ElectronicCats/RAMN/hardware/V1_revB/Global_Library/3D/5002.step

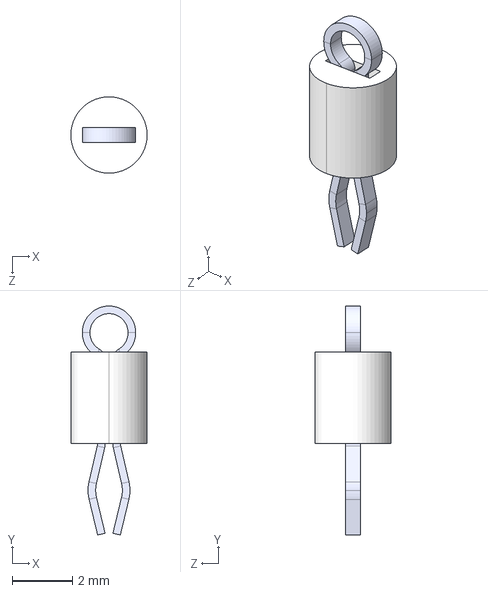
[picture p1: CAD file, 2024-08-29]
hardware/V1_revB/Global_Library/3D/5002.step
2.54 x 7.62 x 2.54 mm
