ElectronicCats/RAMN/hardware/V1_revB/3_powertrain/powertrain.kicad_pcb

## KiCad design hardware/V1_revB/3_powertrain/powertrain.kicad_pcb (2026-10-14)

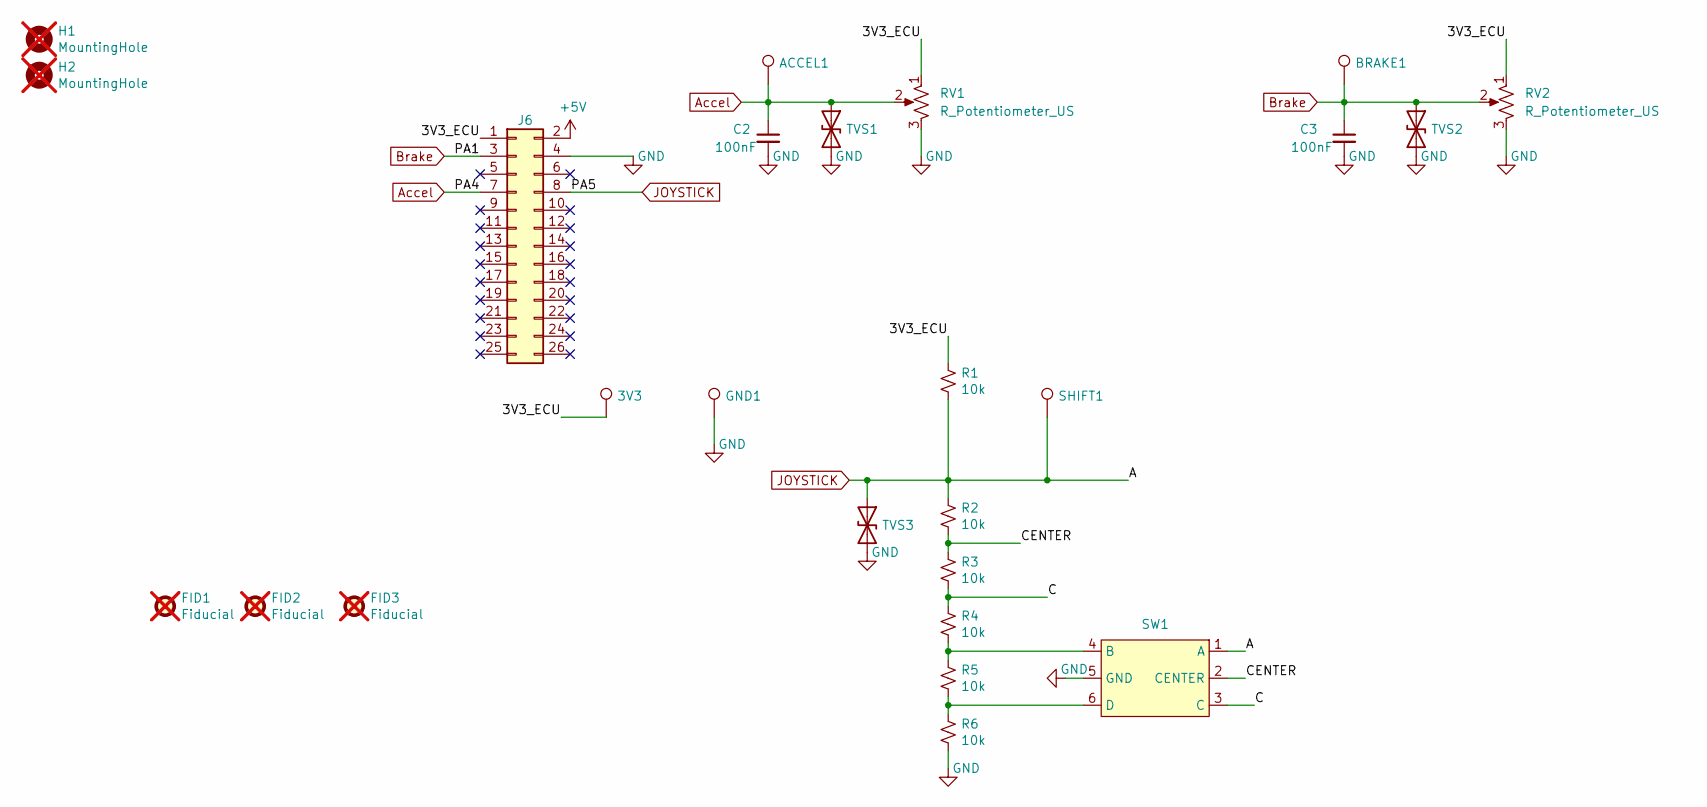
[picture p2: schematic powertrain.kicad_sch, Powertrain - RAMN: Resistant Automotive Miniature Network V1]

Parts:
3V3: TestPoint; KEYSTONE_5002; lcsc# C5277086
ACCEL1: TestPoint; KEYSTONE_5002; lcsc# C5277086
BRAKE1: TestPoint; KEYSTONE_5002; lcsc# C5277086
C2, C3: 100nF; C_0603_1608Metric; lcsc# C282519
FID1, FID2, FID3: Fiducial; Fiducial_1mm_Mask2mm; not fitted
GND1: TestPoint; KEYSTONE_5002; lcsc# C5277086
H1, H2: MountingHole; MountingHole_3.2mm_M3_ISO7380; not fitted
J6: PinSocket_2x13_P2.54mm_Vertical; lcsc# C2897414
R1, R2, R3, R4, R5, R6: 10k; R_0603_1608Metric; lcsc# C209220
RV1, RV2: R_Potentiometer_US; RS15111A900B; lcsc# C470417
SHIFT1: TestPoint; KEYSTONE_5002; lcsc# C5277086
SW1: SKRHADE010; lcsc# C202415
TVS1, TVS2, TVS3: D_TVS; D_SOD-123F; lcsc# C1849694

Connections:
+5V: J6.2
/3V3_ECU: 3V3.1 (1_1), J6.1, R1.1, RV1.1, RV2.1
/C: R3.2, R4.1, SW1.3 (C)
/CENTER: R2.2, R3.1, SW1.2 (CENTER)
Accel: ACCEL1.1 (1_1), C2.1, J6.7, RV1.2, TVS1.1 (A1)
Brake: BRAKE1.1 (1_1), C3.1, J6.3, RV2.2, TVS2.1 (A1)
GND: C2.2, C3.2, GND1.1 (1_1), J6.4, R6.2, RV1.3, RV2.3, SW1.5 (GND), TVS1.2 (A2), TVS2.2 (A2), TVS3.2 (A2)
JOYSTICK: J6.8, R1.2, R2.1, SHIFT1.1 (1_1), SW1.1 (A), TVS3.1 (A1)
unnamed: R4.2, R5.1, SW1.4 (B)
unnamed: R5.2, R6.1, SW1.6 (D)

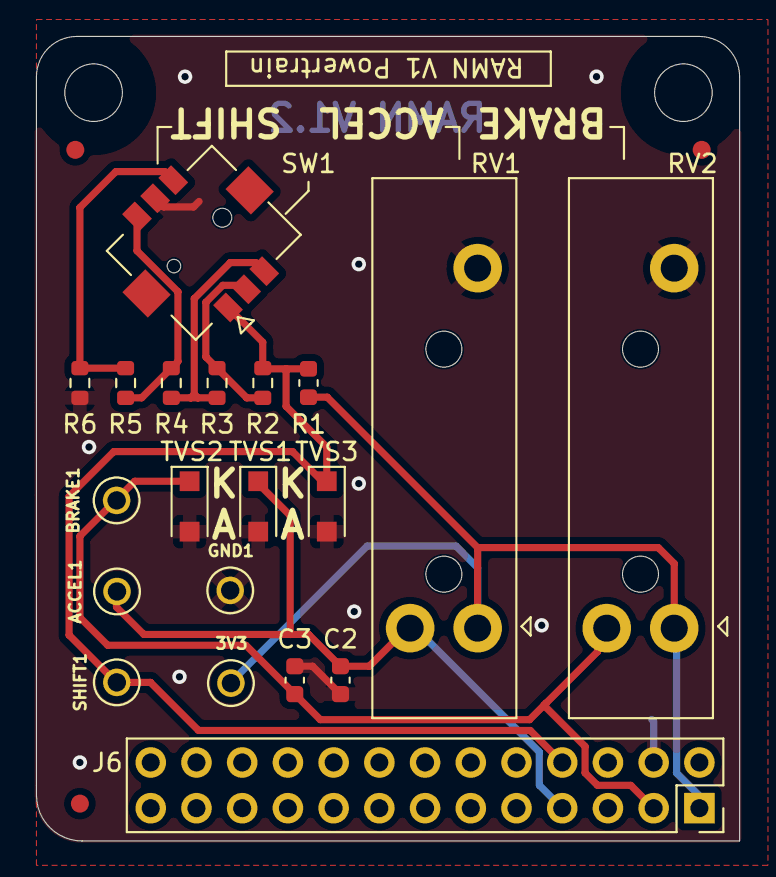
[picture p3: board powertrain.kicad_pcb from above]

Board: 2 copper layers, 39.1 x 44.7 mm, 25 parts (0 on the bottom side), 9 nets.
