ElectronicCats/RAMN/hardware/V1_revB/2_chassis/chassis.kicad_pcb

## KiCad design hardware/V1_revB/2_chassis/chassis.kicad_pcb (2026-10-14)

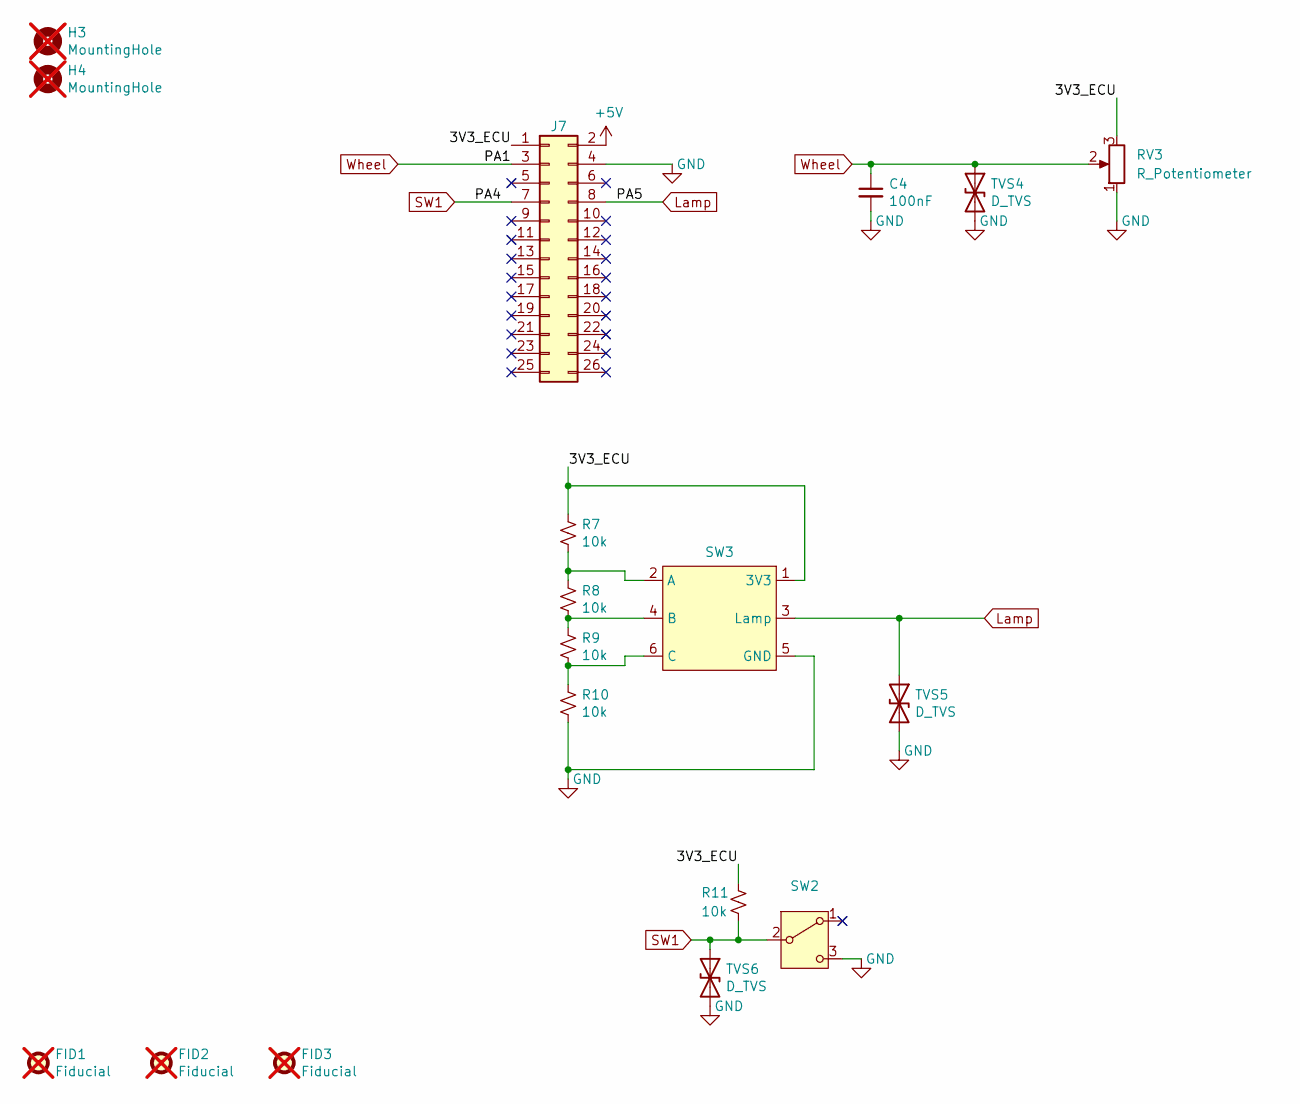
[picture p4: schematic chassis.kicad_sch, Chassis - RAMN: Resistant Automotive Miniature Network V1]

Parts:
C4: 100nF; C_0603_1608Metric; lcsc# C282519
FID1, FID2, FID3: Fiducial; Fiducial_1mm_Mask2mm; not fitted
H3, H4: MountingHole; MountingHole_3.2mm_M3_ISO7380; not fitted
J7: PinSocket_2x13_P2.54mm_Vertical; lcsc# C2897414
R7, R8, R9, R10, R11: 10k; R_0603_1608Metric; lcsc# C73809
RV3: R_Potentiometer; New_Pot; lcsc# C6139964
SW2: SW_CuK_OS102011MA1QN1_SPDT_Angled; lcsc# C226259
SW3: NR01; lcsc# C7250022
TVS4, TVS5, TVS6: D_TVS; D_SOD-123F; lcsc# C1849694

Connections:
+5V: J7.2
/3V3_ECU: J7.1, R7.1, R11.2, RV3.3, SW3.1 (3V3)
GND: C4.2, J7.4, R10.2, RV3.1, SW2.3 (C), SW3.5 (GND), TVS4.2 (A2), TVS5.2 (A2), TVS6.2 (A2)
Lamp: J7.8, SW3.3 (Lamp), TVS5.1 (A1)
unnamed: R7.2, R8.1, SW3.2 (A)
unnamed: R8.2, R9.1, SW3.4 (B)
unnamed: R9.2, R10.1, SW3.6 (C)
SW1: J7.7, R11.1, SW2.2 (B), TVS6.1 (A1)
Wheel: C4.1, J7.3, RV3.2, TVS4.1 (A1)

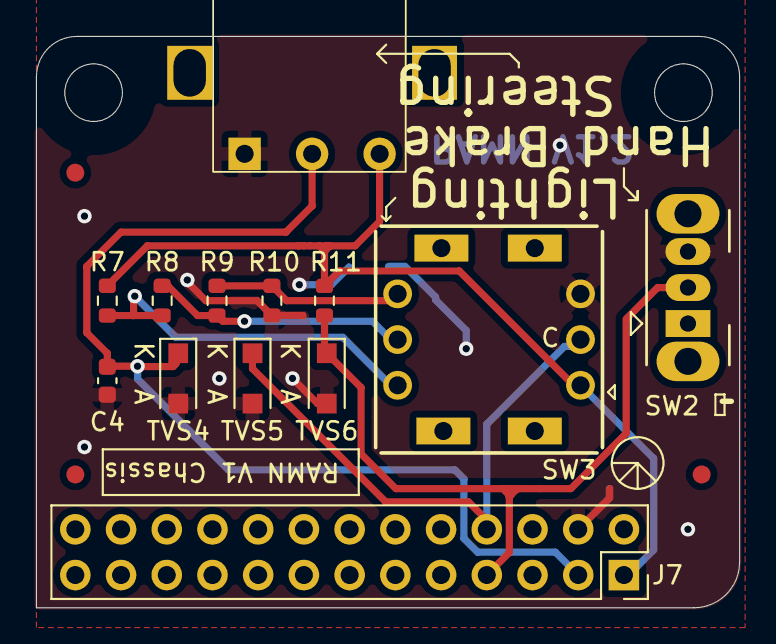
[picture p5: board chassis.kicad_pcb from above]

Board: 2 copper layers, 39.1 x 31.7 mm, 18 parts (0 on the bottom side), 8 nets.
