ElectronicCats/RAMN/hardware/V1_revB/4_body/body.kicad_pcb

## KiCad design hardware/V1_revB/4_body/body.kicad_pcb (2026-09-14)

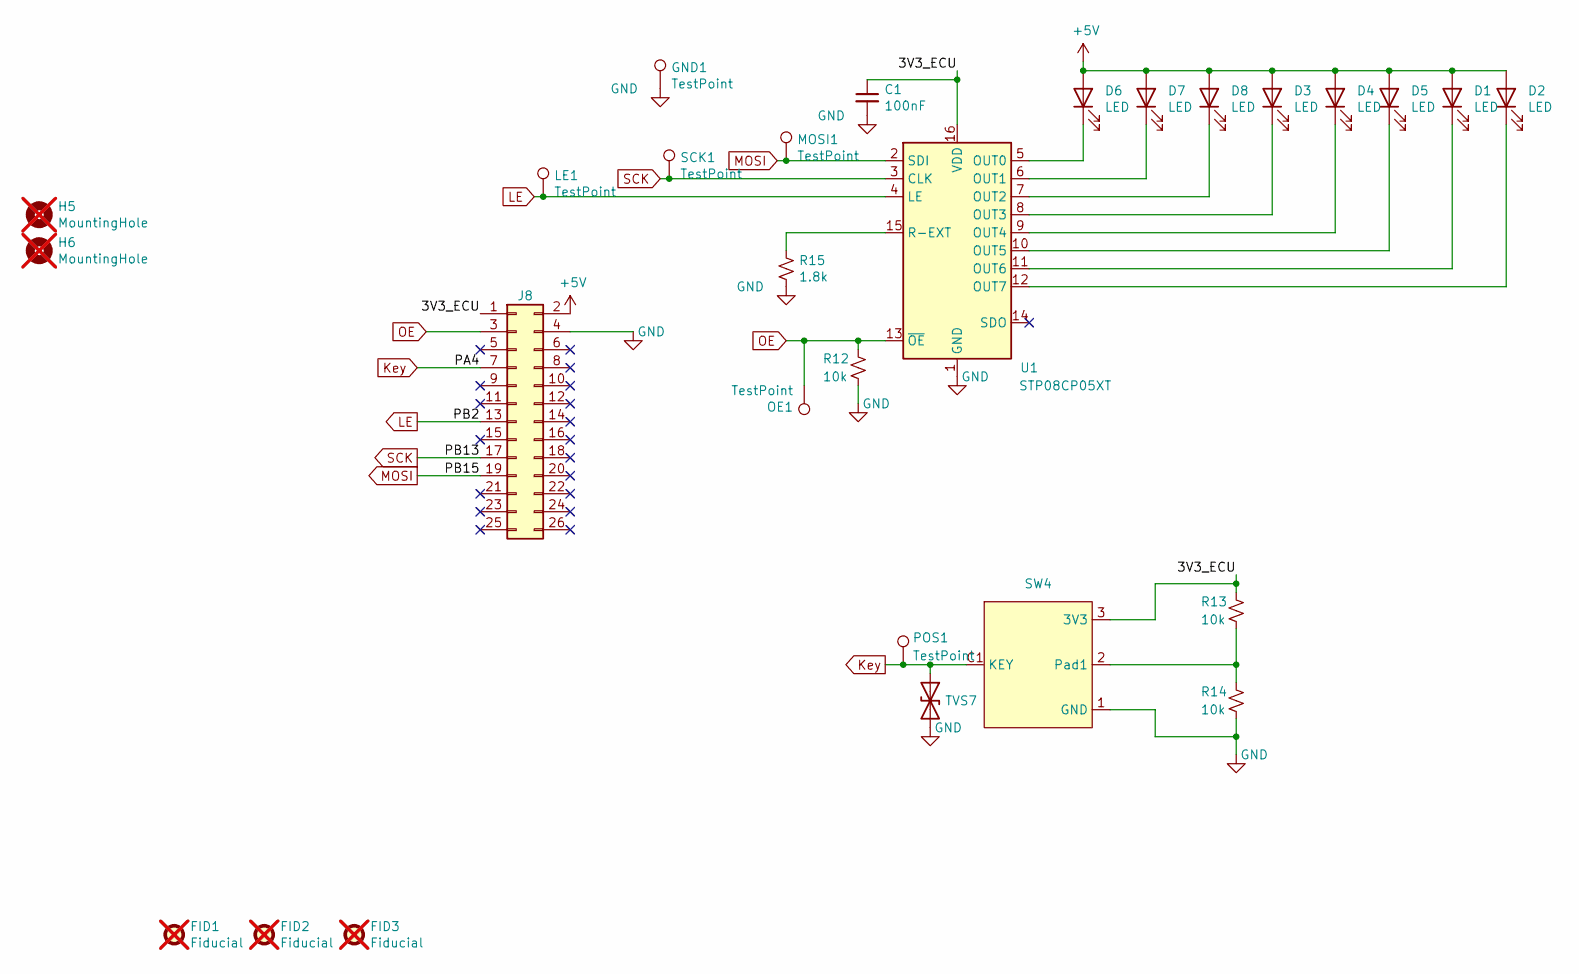
[picture p6: schematic body.kicad_sch, Body - RAMN: Resistant Automotive Miniature Network V1]

Parts:
C1: 100nF; C_0603_1608Metric; lcsc# C282519
D1, D2, D6: LED; LED_0603_1608Metric; lcsc# C51933295
D3, D4, D5: LED; LED_0603_1608Metric; lcsc# C510294
D7: LED; LED_0603_1608Metric; lcsc# C19273153
D8: LED; LED_0603_1608Metric; lcsc# C51933292
FID1, FID2, FID3: Fiducial; Fiducial_1mm_Mask2mm; not fitted
GND1: TestPoint; KEYSTONE_5002; lcsc# C5277086
H5, H6: MountingHole; MountingHole_3.2mm_M3_ISO7380; not fitted
J8: PinSocket_2x13_P2.54mm_Vertical; lcsc# C2897414
LE1: TestPoint; KEYSTONE_5002; lcsc# C5277086
MOSI1: TestPoint; KEYSTONE_5002; lcsc# C5277086
OE1: TestPoint; KEYSTONE_5002; lcsc# C5277086
POS1: TestPoint; KEYSTONE_5002; lcsc# C5277086
R12, R13, R14: 10k; R_0603_1608Metric; lcsc# C209220
R15: 1.8k; R_0603_1608Metric; lcsc# C171725
SCK1: TestPoint; KEYSTONE_5002; lcsc# C5277086
SW4: SK14dG13; lcsc# C34362858
TVS7: D_TVS; D_SOD-123F; lcsc# C1849694
U1: STP08CP05XT; HTSSOP-16-1EP_4.4x5mm_P0.65mm_EP3x3mm; lcsc# C2678539

Connections:
+5V: D1.2 (A), D2.2 (A), D3.2 (A), D4.2 (A), D5.2 (A), D6.2 (A), D7.2 (A), D8.2 (A), J8.2
/3V3_ECU: C1.1, J8.1, R13.2, SW4.3 (3V3), U1.16 (VDD)
GND: C1.2, GND1.1 (1_1), J8.4, R12.1, R14.1, R15.1, SW4.1 (GND), TVS7.2 (A2), U1.1 (GND), U1.17 (GND)
Key: J8.7, POS1.1 (1_1), SW4.C1 (KEY), TVS7.1 (A1)
LE: J8.13, LE1.1 (1_1), U1.4 (LE)
MOSI: J8.19, MOSI1.1 (1_1), U1.2 (SDI)
unnamed: D1.1 (K), U1.11 (OUT6)
unnamed: D2.1 (K), U1.12 (OUT7)
unnamed: D3.1 (K), U1.8 (OUT3)
unnamed: D4.1 (K), U1.9 (OUT4)
unnamed: D5.1 (K), U1.10 (OUT5)
unnamed: D6.1 (K), U1.5 (OUT0)
unnamed: D7.1 (K), U1.6 (OUT1)
unnamed: D8.1 (K), U1.7 (OUT2)
unnamed: R13.1, R14.2, SW4.2 (Pad1)
unnamed: R15.2, U1.15 (R-EXT)
OE: J8.3, OE1.1 (1_1), R12.2, U1.13 (~OE)
SCK: J8.17, SCK1.1 (1_1), U1.3 (CLK)

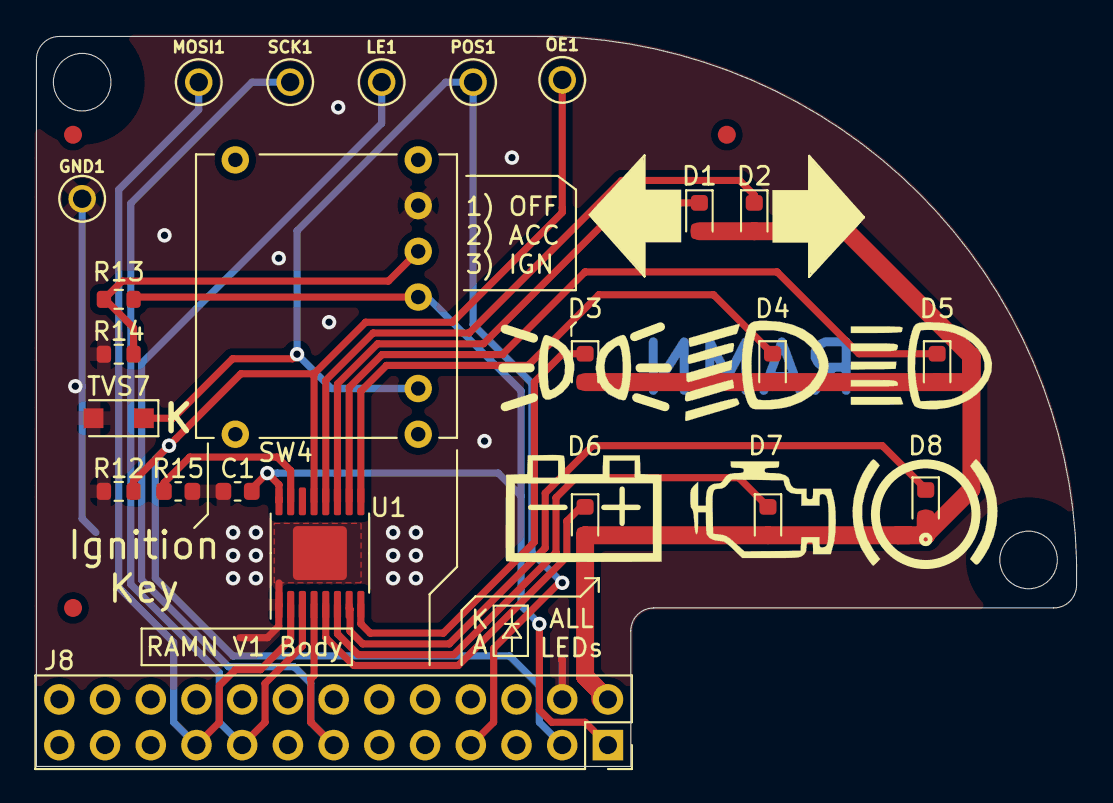
[picture p7: board body.kicad_pcb from above]

Board: 2 copper layers, 57.8 x 40.6 mm, 28 parts (0 on the bottom side), 18 nets.
