ElectronicCats/RAMN/hardware/V1_revB/1_screens/screens.kicad_pcb

## KiCad design hardware/V1_revB/1_screens/screens.kicad_pcb (2026-09-14)

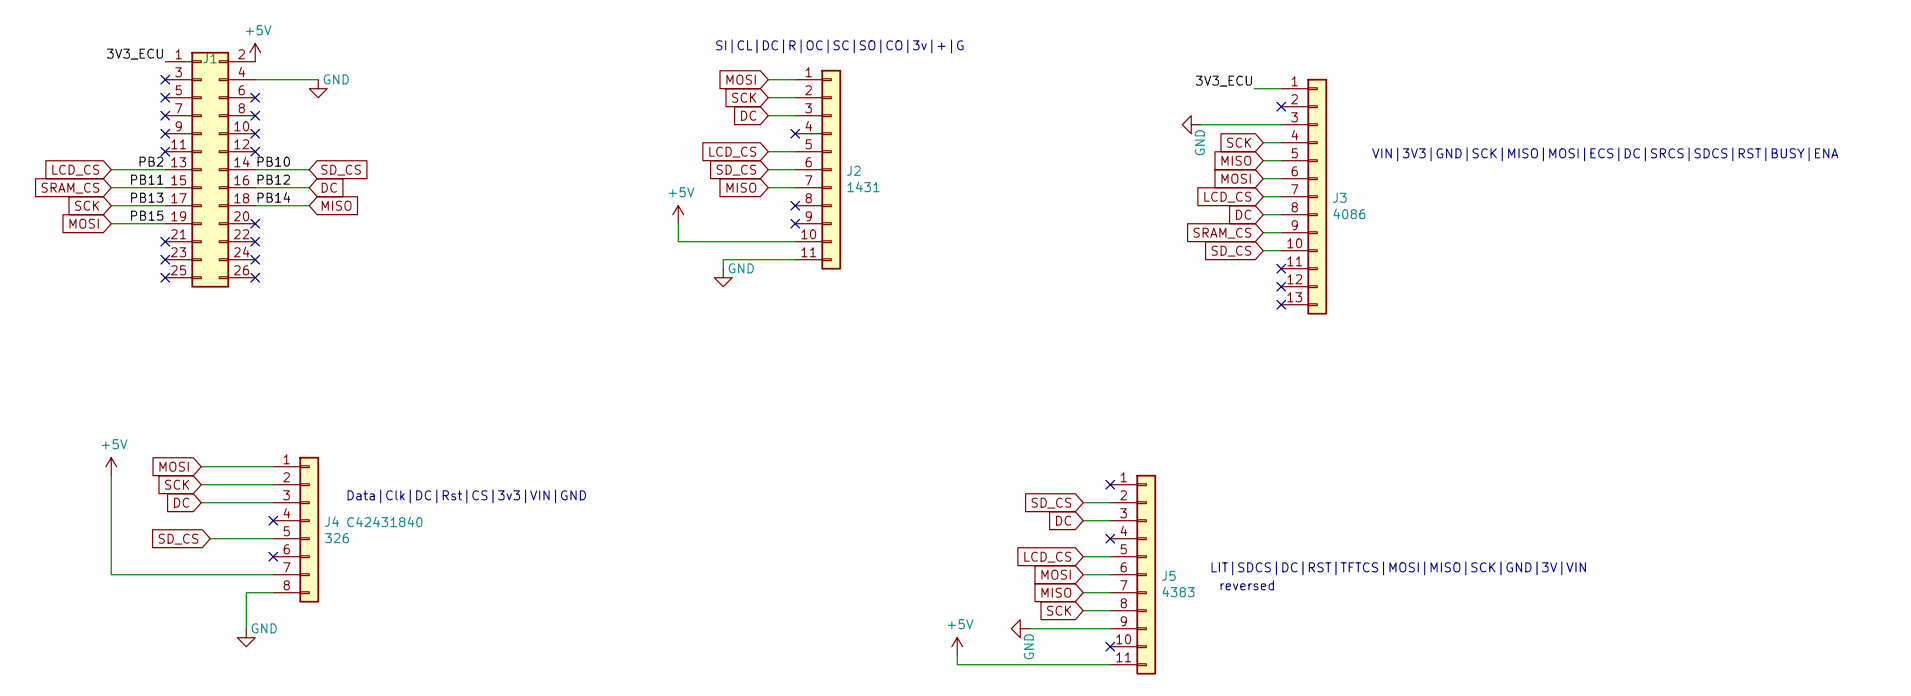
[picture p8: schematic screens.kicad_sch, Screens - RAMN: Resistant Automotive Miniature Network V1]

Parts:
J1: PinHeader_2x13_P2.54mm_Horizontal; LCSC C5412932
J2: 1431; PinSocket_1x11_P2.54mm_Vertical; LCSC C41417323
J3: 4086; PinSocket_1x13_P2.54mm_Vertical; LCSC C2905420
J4: 326; PinSocket_1x08_P2.54mm_Vertical; LCSC C42431840
J5: 4383; PinSocket_1x11_P2.54mm_Vertical; LCSC C41417323

Connections:
+5V: J1.2, J2.10, J4.7, J5.11
/3V3_ECU: J1.1, J3.1
DC: J1.16, J2.3, J3.8, J4.3, J5.3
GND: J1.4, J2.11, J3.3, J4.8, J5.9
LCD_CS: J1.13, J2.5, J3.7, J5.5
MISO: J1.18, J2.7, J3.5, J5.7
MOSI: J1.19, J2.1, J3.6, J4.1, J5.6
SCK: J1.17, J2.2, J3.4, J4.2, J5.8
SD_CS: J1.14, J2.6, J3.10, J4.5, J5.2
SRAM_CS: J1.15, J3.9

Notes on the sheet:
reversed
Data|Clk|DC|Rst|CS|3v3|VIN|GND
LIT|SDCS|DC|RST|TFTCS|MOSI|MISO|SCK|GND|3V|VIN
VIN|3V3|GND|SCK|MISO|MOSI|ECS|DC|SRCS|SDCS|RST|BUSY|ENA
SI|CL|DC|R|OC|SC|SO|CO|3v|+|G

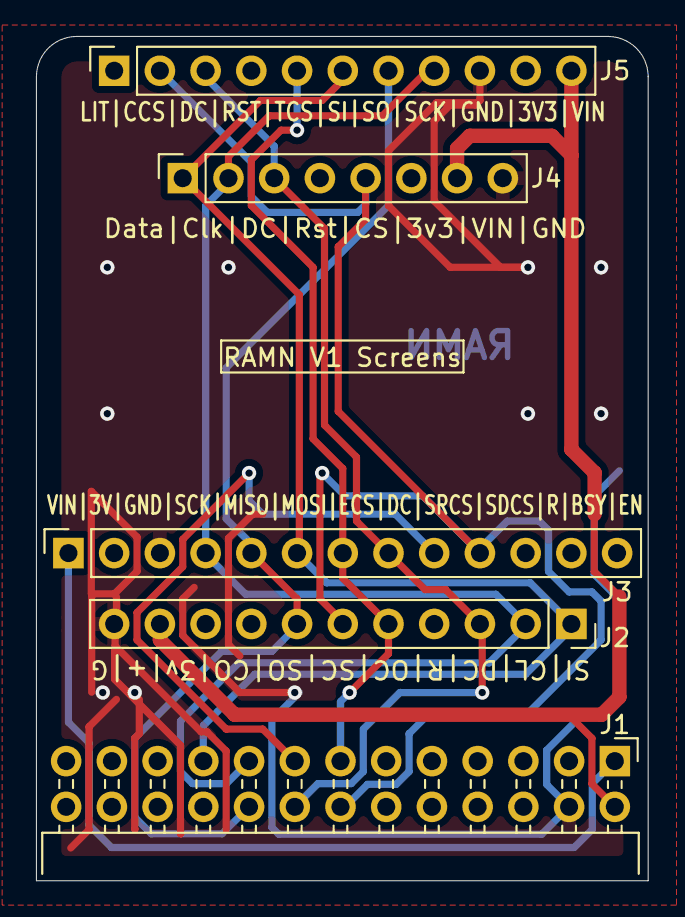
[picture p9: board screens.kicad_pcb from above]

Board: 2 copper layers, 34.0 x 46.9 mm, 5 parts (0 on the bottom side), 10 nets.
