ElectronicCats/RAMN/hardware/V1_revB/5_debugger/debugger.kicad_pcb

## KiCad design hardware/V1_revB/5_debugger/debugger.kicad_pcb (2026-09-14)

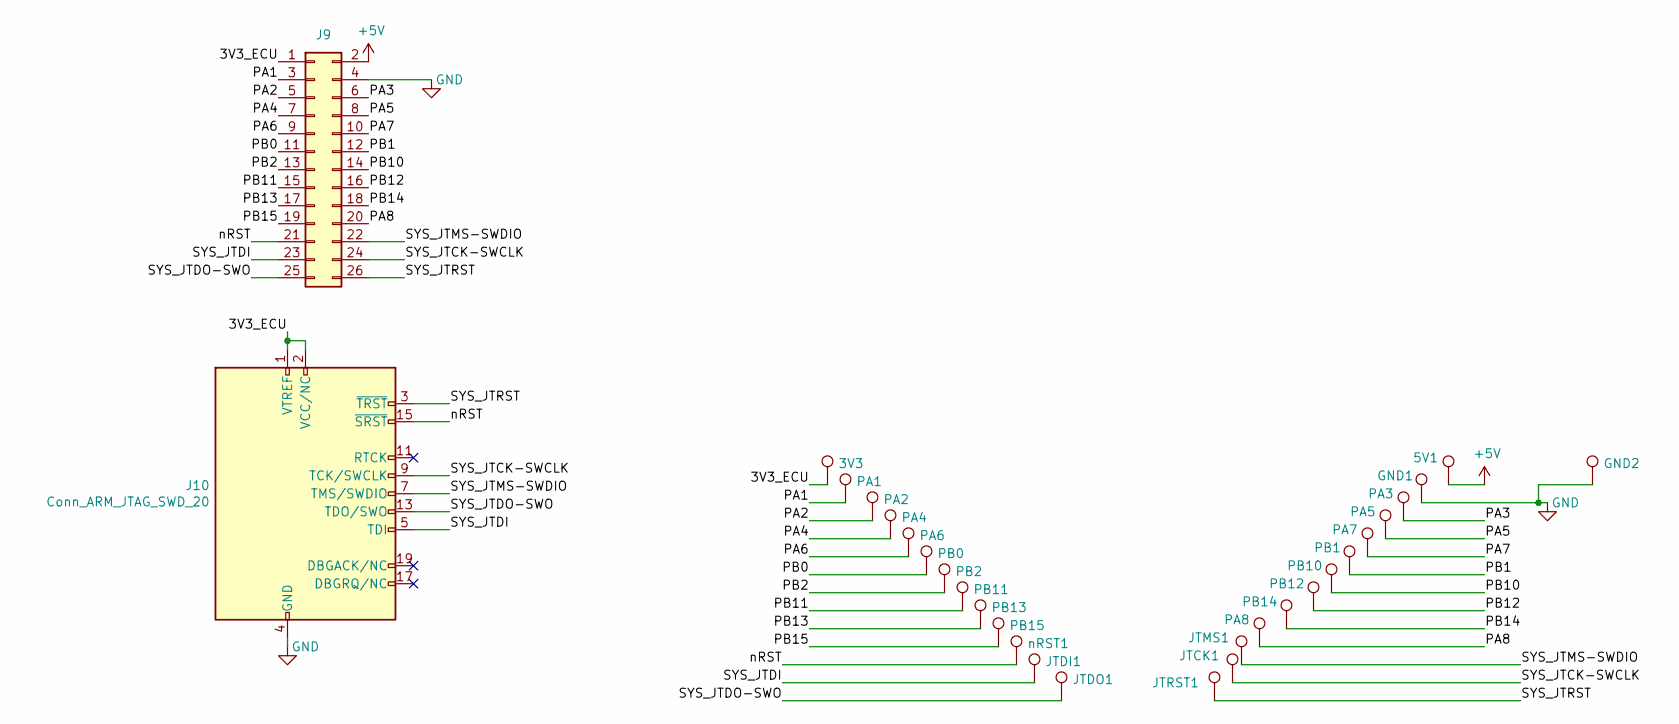
[picture p10: schematic debugger.kicad_sch, Debugger breakout - RAMN V1]

Parts:
3V3, 5V1: TestPoint; KEYSTONE_5002; lcsc# C5277086
GND1, GND2: TestPoint; KEYSTONE_5002; lcsc# C5277086
J9: PinSocket_2x13_P2.54mm_Vertical; lcsc# C2897414
J10: Conn_ARM_JTAG_SWD_20; IDC-Header_2x10_P2.54mm_Horizontal; lcsc# C7527716
JTCK1: TestPoint; KEYSTONE_5002; lcsc# C5277086
JTDI1: TestPoint; KEYSTONE_5002; lcsc# C5277086
JTDO1: TestPoint; KEYSTONE_5002; lcsc# C5277086
JTMS1: TestPoint; KEYSTONE_5002; lcsc# C5277086
JTRST1: TestPoint; KEYSTONE_5002; lcsc# C5277086
PA1, PA2, PA3, PA4, PA5, PA6, PA7, PA8: TestPoint; KEYSTONE_5002; lcsc# C5277086
PB0, PB1, PB2, PB10, PB11, PB12, PB13, PB14, PB15: TestPoint; KEYSTONE_5002; lcsc# C5277086
nRST1: TestPoint; KEYSTONE_5002; lcsc# C5277086

Connections:
+5V: 5V1.1 (1_1), J9.2
/3V3_ECU: 3V3.1 (1_1), J9.1, J10.1 (VTREF), J10.2 (VCC/NC)
/PA1: J9.3, PA1.1 (1_1)
/PA2: J9.5, PA2.1 (1_1)
/PA3: J9.6, PA3.1 (1_1)
/PA4: J9.7, PA4.1 (1_1)
/PA5: J9.8, PA5.1 (1_1)
/PA6: J9.9, PA6.1 (1_1)
/PA7: J9.10, PA7.1 (1_1)
/PA8: J9.20, PA8.1 (1_1)
/PB0: J9.11, PB0.1 (1_1)
/PB1: J9.12, PB1.1 (1_1)
/PB2: J9.13, PB2.1 (1_1)
/PB10: J9.14, PB10.1 (1_1)
/PB11: J9.15, PB11.1 (1_1)
/PB12: J9.16, PB12.1 (1_1)
/PB13: J9.17, PB13.1 (1_1)
/PB14: J9.18, PB14.1 (1_1)
/PB15: J9.19, PB15.1 (1_1)
/SYS_JTCK-SWCLK: J9.24, J10.9 (TCK/SWCLK), JTCK1.1 (1_1)
/SYS_JTDI: J9.23, J10.5 (TDI), JTDI1.1 (1_1)
/SYS_JTDO-SWO: J9.25, J10.13 (TDO/SWO), JTDO1.1 (1_1)
/SYS_JTMS-SWDIO: J9.22, J10.7 (TMS/SWDIO), JTMS1.1 (1_1)
/SYS_JTRST: J9.26, J10.3 (~TRST), JTRST1.1 (1_1)
/nRST: J9.21, J10.15 (~SRST), nRST1.1 (1_1)
GND: GND1.1 (1_1), GND2.1 (1_1), J9.4, J10.4 (GND), J10.6 (GND), J10.8 (GND), J10.10 (GND), J10.12 (GND), J10.14 (GND), J10.16 (GND), J10.18 (GND), J10.20 (GND)

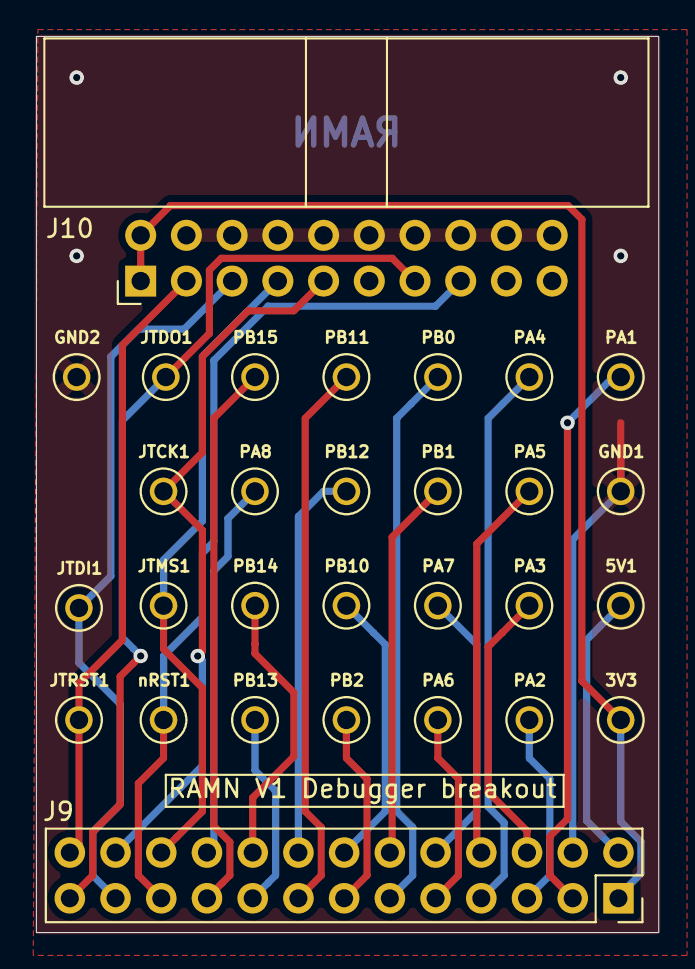
[picture p11: board debugger.kicad_pcb from above]

Board: 2 copper layers, 34.6 x 49.8 mm, 29 parts (0 on the bottom side), 26 nets.
