ElectronicCats/RAMN/hardware/V1_revB/0_ramn/ramn.kicad_pcb

## KiCad design hardware/V1_revB/0_ramn/ramn.kicad_pcb (2026-09-14)

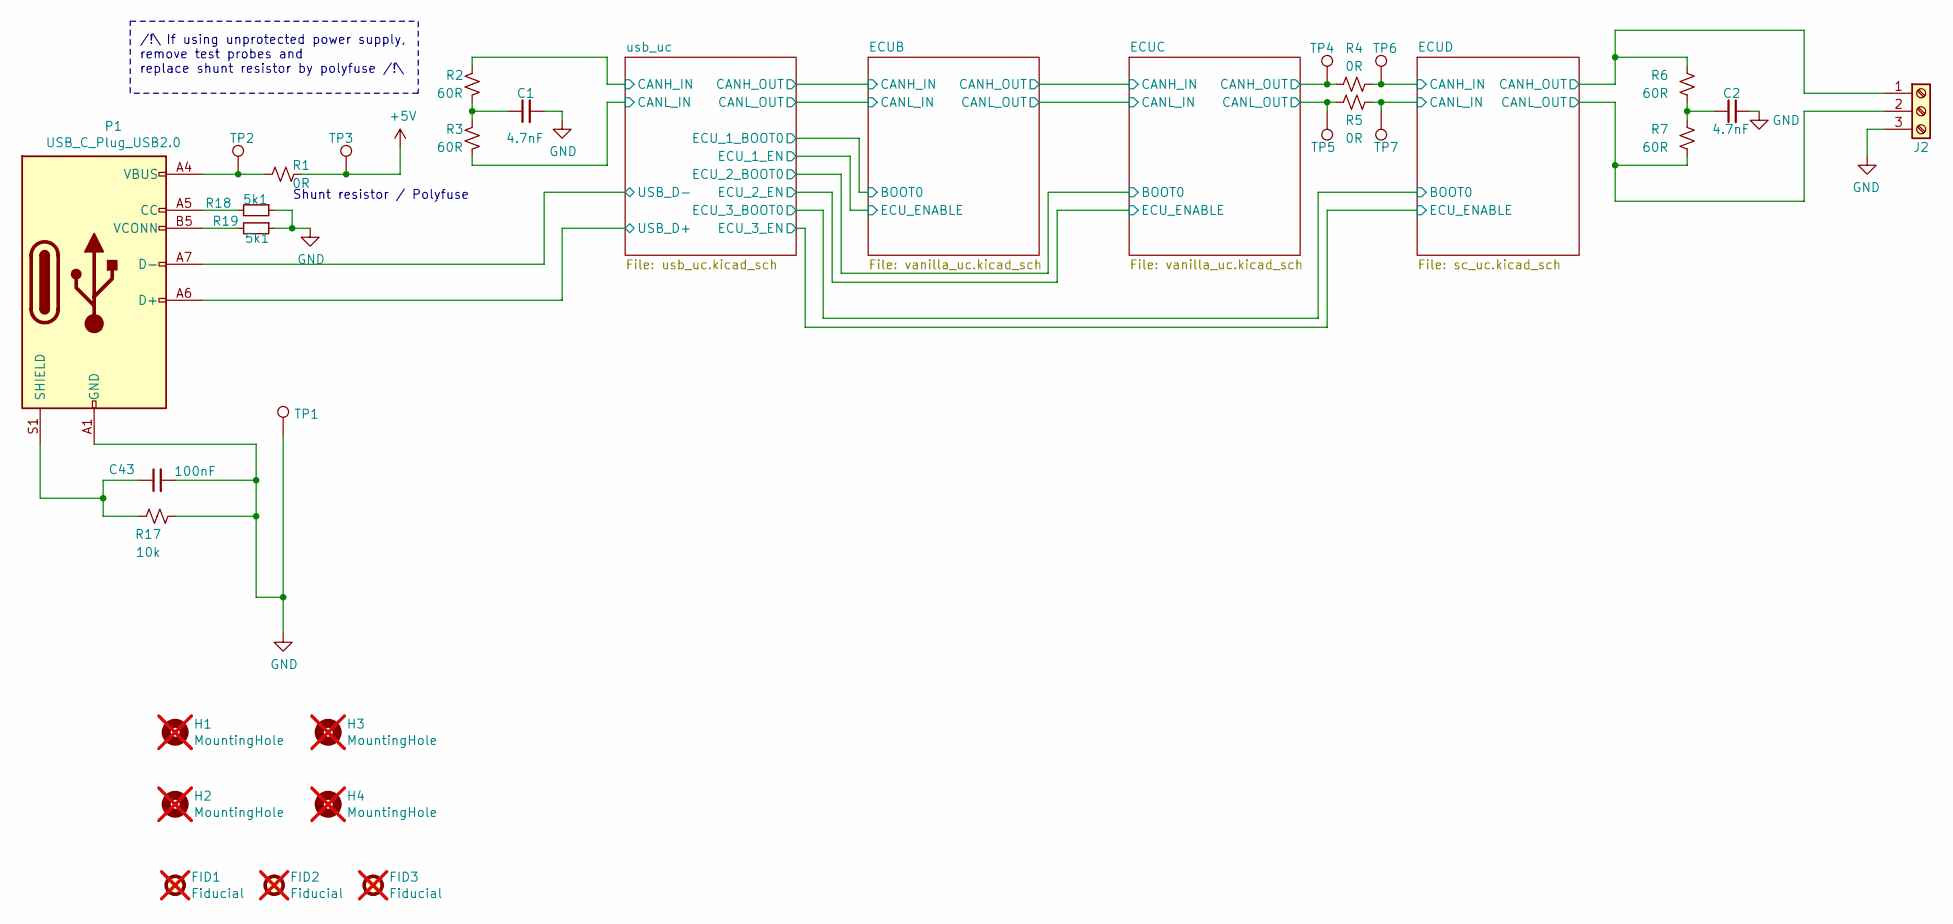
[picture p12: schematic ramn.kicad_sch, RAMN: Resistant Automotive Miniature Network V1.0]

Parts:
C1, C2: 4.7nF; C_0603_1608Metric; lcsc# C335546
C43: 100nF; C_0603_1608Metric; lcsc# C599645
FID1, FID2, FID3: Fiducial; Fiducial_1mm_Mask2mm; not fitted
H1, H2, H3, H4: MountingHole; MountingHole_3.2mm_M3_ISO7380; not fitted
J2: Screw_Terminal_01x03; TerminalBlock_Phoenix_PTSM-0,5-3-2.5-V-THR_1x03_P2.50mm_Ver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; lcsc# C5443579
P1: USB_C_Plug_USB2.0; C393939; lcsc# C393939
R1, R4, R5: 0R; R_0603_1608Metric; lcsc# C95177
R2, R3, R6, R7: 60R; R_0603_1608Metric; lcsc# C23090
R17: 10k; R_0603_1608Metric; lcsc# C98220
R18, R19: 5k1; R_0603_1608Metric; lcsc# C191782
TP1, TP2, TP3, TP4, TP5, TP6, TP7: KEYSTONE_5002; lcsc# C5277086

Connections:
+5V: R1.1, TP3.1 (1_1); also elsewhere on the board
/ECUB/CANH_IN: R2.1, R4.2, TP4.1 (1_1); also elsewhere on the board
/ECUB/CANL_IN: R3.2, R5.2, TP5.1 (1_1); also elsewhere on the board
/ECUD/CANH_IN: J2.1, R4.1, R6.1, TP6.1 (1_1); also elsewhere on the board
/ECUD/CANL_IN: J2.2, R5.1, R7.2, TP7.1 (1_1); also elsewhere on the board
/usb_uc/USB_D+: P1.A6 (D+); also elsewhere on the board
/usb_uc/USB_D-: P1.A7 (D-); also elsewhere on the board
GND: C1.2, C2.2, C43.2, J2.3, P1.A1 (GND), P1.A12 (GND), P1.B1 (GND), P1.B12 (GND), R17.2, R18.1, R19.1, TP1.1 (1_1); also elsewhere on the board
unnamed: C1.1, R2.2, R3.1
unnamed: C2.1, R6.2, R7.1
unnamed: P1.A5 (CC), R18.2
unnamed: C43.1, P1.S1 (SHIELD), R17.1
unnamed: P1.A4 (VBUS), P1.A9 (VBUS), P1.B4 (VBUS), P1.B9 (VBUS), R1.2, TP2.1 (1_1)
unnamed: P1.B5 (VCONN), R19.2

Notes on the sheet:
/!\ If using unprotected power supply, remove test probes and replace shunt resistor by polyfuse /!\
Shunt resistor / Polyfuse

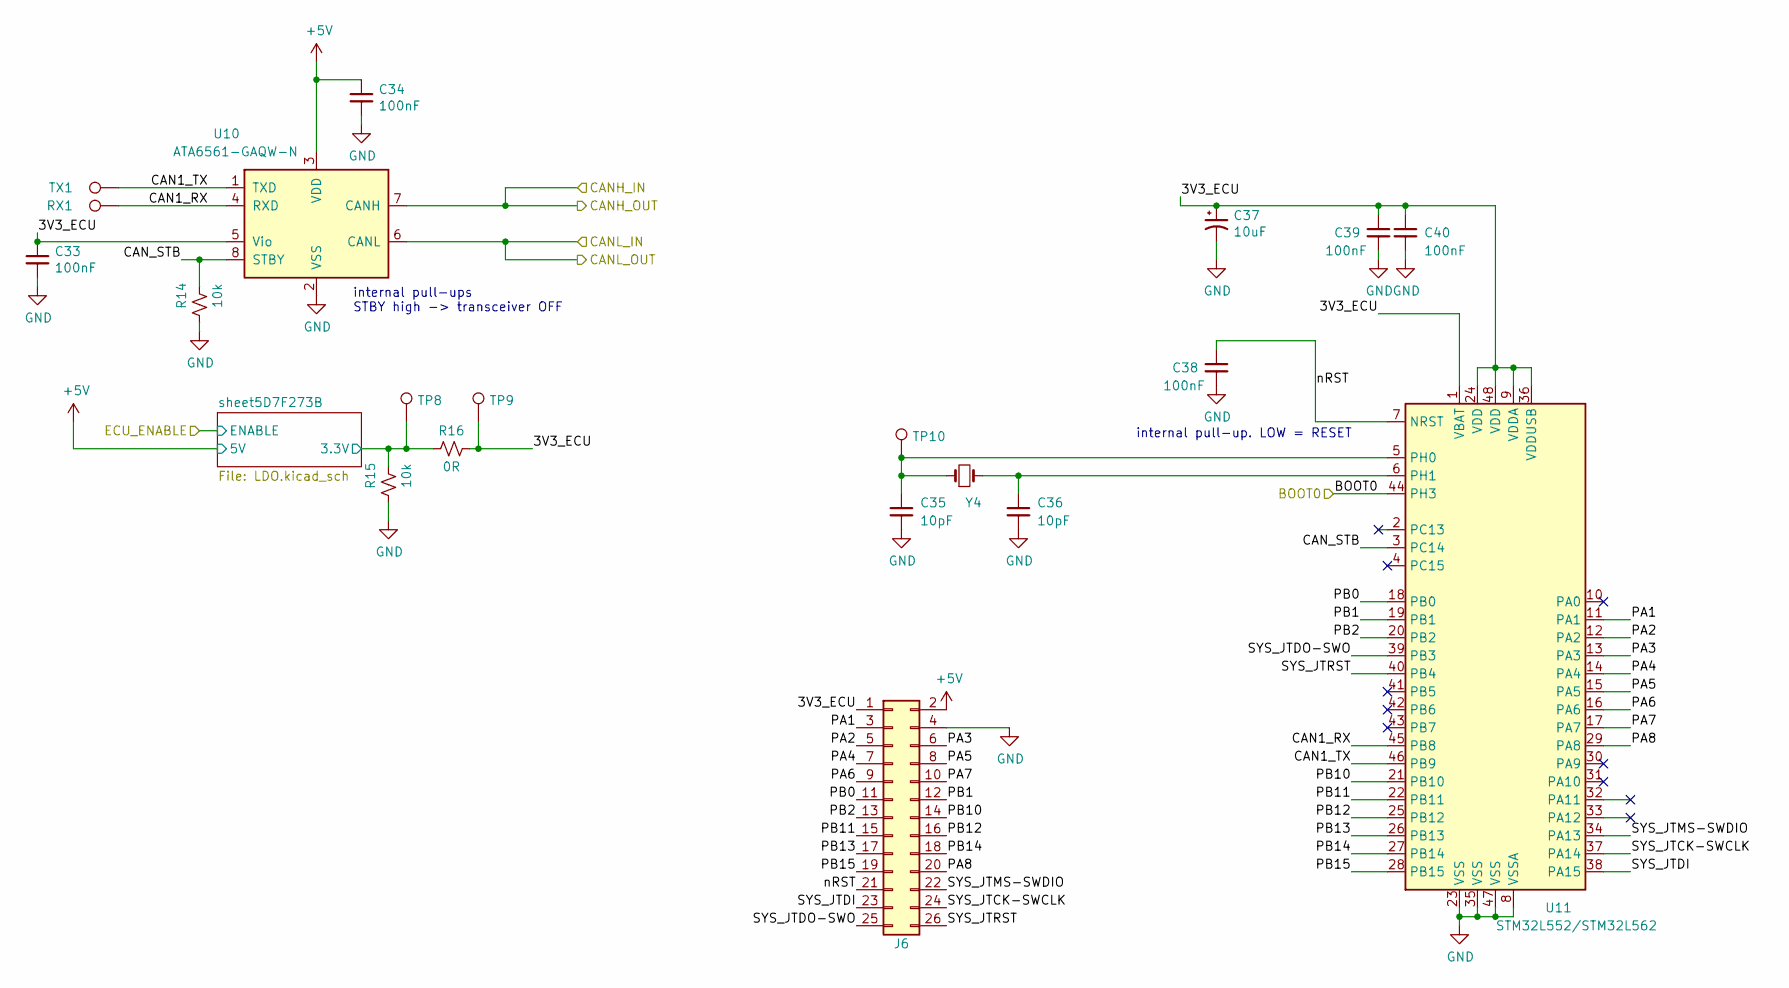
[picture p13: schematic sc_uc.kicad_sch, RAMN: Resistant Automotive Miniature Network V1.0]

Parts:
C33, C34, C38, C39, C40: 100nF; C_0603_1608Metric; lcsc# C599645
C35, C36: 10pF; C_0603_1608Metric; lcsc# C9807
C37: 10uF; C_1206_3216Metric; lcsc# C1848
J6: PinSocket_2x13_P2.54mm_Vertical; lcsc# C2897414
R14, R15: 10k; R_0603_1608Metric; lcsc# C98220
R16: 0R; R_0603_1608Metric; lcsc# C95177
RX1: TestPoint_Pad_D1.0mm; lcsc# C5277086
TP8, TP9, TP10: KEYSTONE_5002; lcsc# C5277086
TX1: TestPoint_Pad_D1.0mm; lcsc# C5277086
U10: ATA6561-GAQW-N; SOIC-8_3.9x4.9mm_P1.27mm; lcsc# C124015
U11: STM32L552/STM32L562; LQFP-48_7x7mm_P0.5mm; lcsc# C2969980
Y4: NX3225GD-8MHZ-STD-CRA-3; SMD-2_3.2x2.5mm; lcsc# C889706

Connections:
+5V: C34.1, J6.2, U10.3 (VDD); also elsewhere on the board
/ECUD/3V3_ECU: C33.1, C37.1, C39.1, C40.1, J6.1, R16.1, TP9.1 (1_1), U10.5 (Vio), U11.1 (VBAT), U11.9 (VDDA), U11.24 (VDD), U11.36 (VDDUSB), U11.48 (VDD)
/ECUD/BOOT0: U11.44 (PH3); also elsewhere on the board
/ECUD/CAN1_RX: RX1.1 (1_1), U10.4 (RXD), U11.45 (PB8)
/ECUD/CAN1_TX: TX1.1 (1_1), U10.1 (TXD), U11.46 (PB9)
/ECUD/CANH_IN: U10.7 (CANH); also elsewhere on the board
/ECUD/CANL_IN: U10.6 (CANL); also elsewhere on the board
/ECUD/CAN_STB: R14.1, U10.8 (STBY), U11.3 (PC14)
/ECUD/PA1: J6.3, U11.11 (PA1)
/ECUD/PA2: J6.5, U11.12 (PA2)
/ECUD/PA3: J6.6, U11.13 (PA3)
/ECUD/PA4: J6.7, U11.14 (PA4)
/ECUD/PA5: J6.8, U11.15 (PA5)
/ECUD/PA6: J6.9, U11.16 (PA6)
/ECUD/PA7: J6.10, U11.17 (PA7)
/ECUD/PA8: J6.20, U11.29 (PA8)
/ECUD/PB0: J6.11, U11.18 (PB0)
/ECUD/PB1: J6.12, U11.19 (PB1)
/ECUD/PB2: J6.13, U11.20 (PB2)
/ECUD/PB10: J6.14, U11.21 (PB10)
/ECUD/PB11: J6.15, U11.22 (PB11)
/ECUD/PB12: J6.16, U11.25 (PB12)
/ECUD/PB13: J6.17, U11.26 (PB13)
/ECUD/PB14: J6.18, U11.27 (PB14)
/ECUD/PB15: J6.19, U11.28 (PB15)
/ECUD/SYS_JTCK-SWCLK: J6.24, U11.37 (PA14)
/ECUD/SYS_JTDI: J6.23, U11.38 (PA15)
/ECUD/SYS_JTDO-SWO: J6.25, U11.39 (PB3)
/ECUD/SYS_JTMS-SWDIO: J6.22, U11.34 (PA13)
/ECUD/SYS_JTRST: J6.26, U11.40 (PB4)
/ECUD/nRST: C38.1, J6.21, U11.7 (NRST)
/ECUD/sheet5D7F273B/3.3V: R15.1, R16.2, TP8.1 (1_1); also elsewhere on the board
GND: C33.2, C34.2, C35.2, C36.2, C37.2, C38.2, C39.2, C40.2, J6.4, R14.2, R15.2, U10.2 (VSS), U11.8 (VSSA), U11.23 (VSS), U11.35 (VSS), U11.47 (VSS); also elsewhere on the board
unnamed: C35.1, TP10.1 (1_1), U11.5 (PH0), Y4.1
unnamed: C36.1, U11.6 (PH1), Y4.2

Notes on the sheet:
internal pull-up. LOW = RESET
internal pull-ups STBY high -> transceiver OFF
