ElectronicCats/RAMN/hardware/V1_revB/0_ramn/ramn.kicad_pcb

## KiCad design hardware/V1_revB/0_ramn/ramn.kicad_pcb (continued)

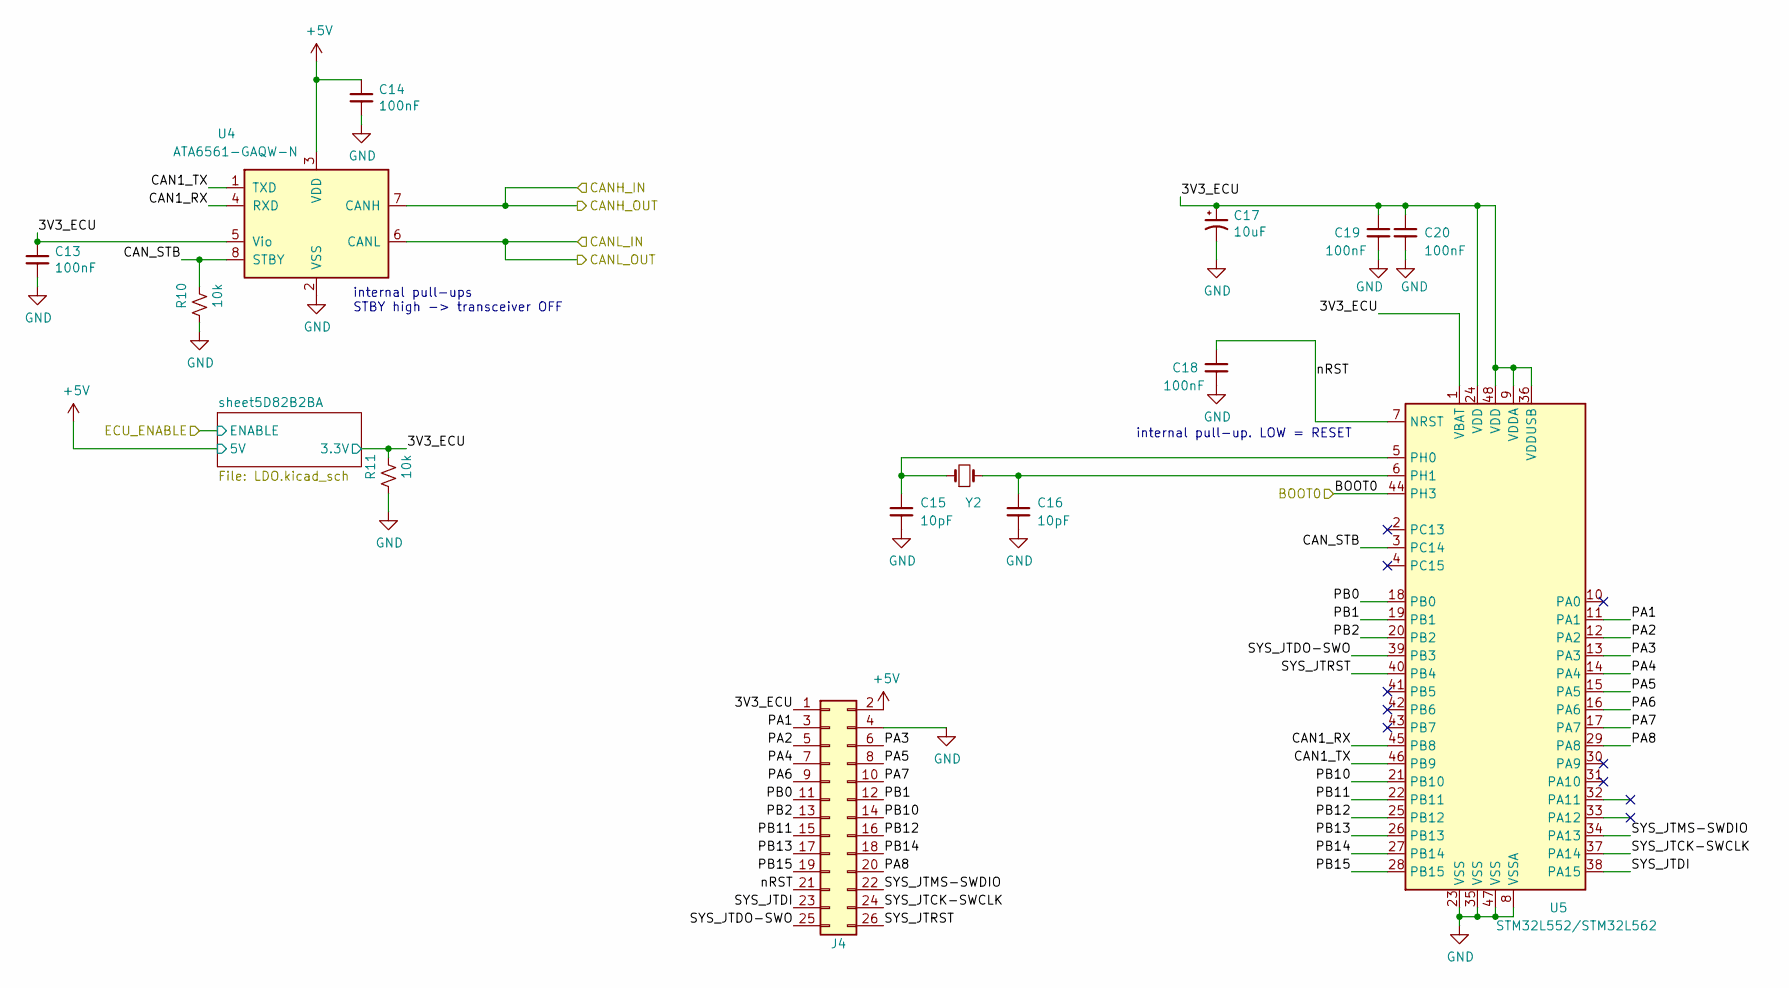
[picture p14: schematic vanilla_uc.kicad_sch, RAMN: Resistant Automotive Miniature Network V1.0]

Parts:
C13, C14, C18, C19, C20: 100nF; C_0603_1608Metric; lcsc# C599645
C15, C16: 10pF; C_0603_1608Metric; lcsc# C9807
C17: 10uF; C_1206_3216Metric; lcsc# C1848
J4: PinSocket_2x13_P2.54mm_Vertical; lcsc# C2897414
R10, R11: 10k; R_0603_1608Metric; lcsc# C98220
U4: ATA6561-GAQW-N; SOIC-8_3.9x4.9mm_P1.27mm; lcsc# C124015
U5: STM32L552/STM32L562; LQFP-48_7x7mm_P0.5mm; lcsc# C2969980
Y2: NX3225GD-8MHZ-STD-CRA-3; SMD-2_3.2x2.5mm; lcsc# C889706

Connections:
+5V: C14.1, J4.2, U4.3 (VDD); also elsewhere on the board
/ECUB/3V3_ECU: C13.1, C17.1, C19.1, C20.1, J4.1, R11.1, U4.5 (Vio), U5.1 (VBAT), U5.9 (VDDA), U5.24 (VDD), U5.36 (VDDUSB), U5.48 (VDD); also elsewhere on the board
/ECUB/BOOT0: U5.44 (PH3); also elsewhere on the board
/ECUB/CAN1_RX: U4.4 (RXD), U5.45 (PB8)
/ECUB/CAN1_TX: U4.1 (TXD), U5.46 (PB9)
/ECUB/CANH_IN: U4.7 (CANH); also elsewhere on the board
/ECUB/CANL_IN: U4.6 (CANL); also elsewhere on the board
/ECUB/CAN_STB: R10.1, U4.8 (STBY), U5.3 (PC14)
/ECUB/PA1: J4.3, U5.11 (PA1)
/ECUB/PA2: J4.5, U5.12 (PA2)
/ECUB/PA3: J4.6, U5.13 (PA3)
/ECUB/PA4: J4.7, U5.14 (PA4)
/ECUB/PA5: J4.8, U5.15 (PA5)
/ECUB/PA6: J4.9, U5.16 (PA6)
/ECUB/PA7: J4.10, U5.17 (PA7)
/ECUB/PA8: J4.20, U5.29 (PA8)
/ECUB/PB0: J4.11, U5.18 (PB0)
/ECUB/PB1: J4.12, U5.19 (PB1)
/ECUB/PB2: J4.13, U5.20 (PB2)
/ECUB/PB10: J4.14, U5.21 (PB10)
/ECUB/PB11: J4.15, U5.22 (PB11)
/ECUB/PB12: J4.16, U5.25 (PB12)
/ECUB/PB13: J4.17, U5.26 (PB13)
/ECUB/PB14: J4.18, U5.27 (PB14)
/ECUB/PB15: J4.19, U5.28 (PB15)
/ECUB/SYS_JTCK-SWCLK: J4.24, U5.37 (PA14)
/ECUB/SYS_JTDI: J4.23, U5.38 (PA15)
/ECUB/SYS_JTDO-SWO: J4.25, U5.39 (PB3)
/ECUB/SYS_JTMS-SWDIO: J4.22, U5.34 (PA13)
/ECUB/SYS_JTRST: J4.26, U5.40 (PB4)
/ECUB/nRST: C18.1, J4.21, U5.7 (NRST)
GND: C13.2, C14.2, C15.2, C16.2, C17.2, C18.2, C19.2, C20.2, J4.4, R10.2, R11.2, U4.2 (VSS), U5.8 (VSSA), U5.23 (VSS), U5.35 (VSS), U5.47 (VSS); also elsewhere on the board
unnamed: C15.1, U5.5 (PH0), Y2.1
unnamed: C16.1, U5.6 (PH1), Y2.2

Parts of its further copies:
C23, C24, C28, C29, C30: 100nF; C_0603_1608Metric; lcsc# C599645
C25, C26: 10pF; C_0603_1608Metric; lcsc# C9807
C27: 10uF; C_1206_3216Metric; lcsc# C1848
J5: PinSocket_2x13_P2.54mm_Vertical; lcsc# C2897414
R12, R13: 10k; R_0603_1608Metric; lcsc# C98220
U7: ATA6561-GAQW-N; SOIC-8_3.9x4.9mm_P1.27mm; lcsc# C124015
U8: STM32L552/STM32L562; LQFP-48_7x7mm_P0.5mm; lcsc# C2969980
Y3: NX3225GD-8MHZ-STD-CRA-3; SMD-2_3.2x2.5mm; lcsc# C889706

Connections of its further copies:
+5V: C24.1, J5.2, U7.3 (VDD); also elsewhere on the board
/ECUB/CANH_IN: U7.7 (CANH); also elsewhere on the board
/ECUB/CANL_IN: U7.6 (CANL); also elsewhere on the board
/ECUC/3V3_ECU: C23.1, C27.1, C29.1, C30.1, J5.1, R13.1, U7.5 (Vio), U8.1 (VBAT), U8.9 (VDDA), U8.24 (VDD), U8.36 (VDDUSB), U8.48 (VDD); also elsewhere on the board
/ECUC/BOOT0: U8.44 (PH3); also elsewhere on the board
/ECUC/CAN1_RX: U7.4 (RXD), U8.45 (PB8)
/ECUC/CAN1_TX: U7.1 (TXD), U8.46 (PB9)
/ECUC/CAN_STB: R12.1, U7.8 (STBY), U8.3 (PC14)
/ECUC/PA1: J5.3, U8.11 (PA1)
/ECUC/PA2: J5.5, U8.12 (PA2)
/ECUC/PA3: J5.6, U8.13 (PA3)
/ECUC/PA4: J5.7, U8.14 (PA4)
/ECUC/PA5: J5.8, U8.15 (PA5)
/ECUC/PA6: J5.9, U8.16 (PA6)
/ECUC/PA7: J5.10, U8.17 (PA7)
/ECUC/PA8: J5.20, U8.29 (PA8)
/ECUC/PB0: J5.11, U8.18 (PB0)
/ECUC/PB1: J5.12, U8.19 (PB1)
/ECUC/PB2: J5.13, U8.20 (PB2)
/ECUC/PB10: J5.14, U8.21 (PB10)
/ECUC/PB11: J5.15, U8.22 (PB11)
/ECUC/PB12: J5.16, U8.25 (PB12)
/ECUC/PB13: J5.17, U8.26 (PB13)
/ECUC/PB14: J5.18, U8.27 (PB14)
/ECUC/PB15: J5.19, U8.28 (PB15)
/ECUC/SYS_JTCK-SWCLK: J5.24, U8.37 (PA14)
/ECUC/SYS_JTDI: J5.23, U8.38 (PA15)
/ECUC/SYS_JTDO-SWO: J5.25, U8.39 (PB3)
/ECUC/SYS_JTMS-SWDIO: J5.22, U8.34 (PA13)
/ECUC/SYS_JTRST: J5.26, U8.40 (PB4)
/ECUC/nRST: C28.1, J5.21, U8.7 (NRST)
GND: C23.2, C24.2, C25.2, C26.2, C27.2, C28.2, C29.2, C30.2, J5.4, R12.2, R13.2, U7.2 (VSS), U8.8 (VSSA), U8.23 (VSS), U8.35 (VSS), U8.47 (VSS); also elsewhere on the board
unnamed: C25.1, U8.5 (PH0), Y3.1
unnamed: C26.1, U8.6 (PH1), Y3.2

Notes on the sheet:
internal pull-up. LOW = RESET
internal pull-ups STBY high -> transceiver OFF

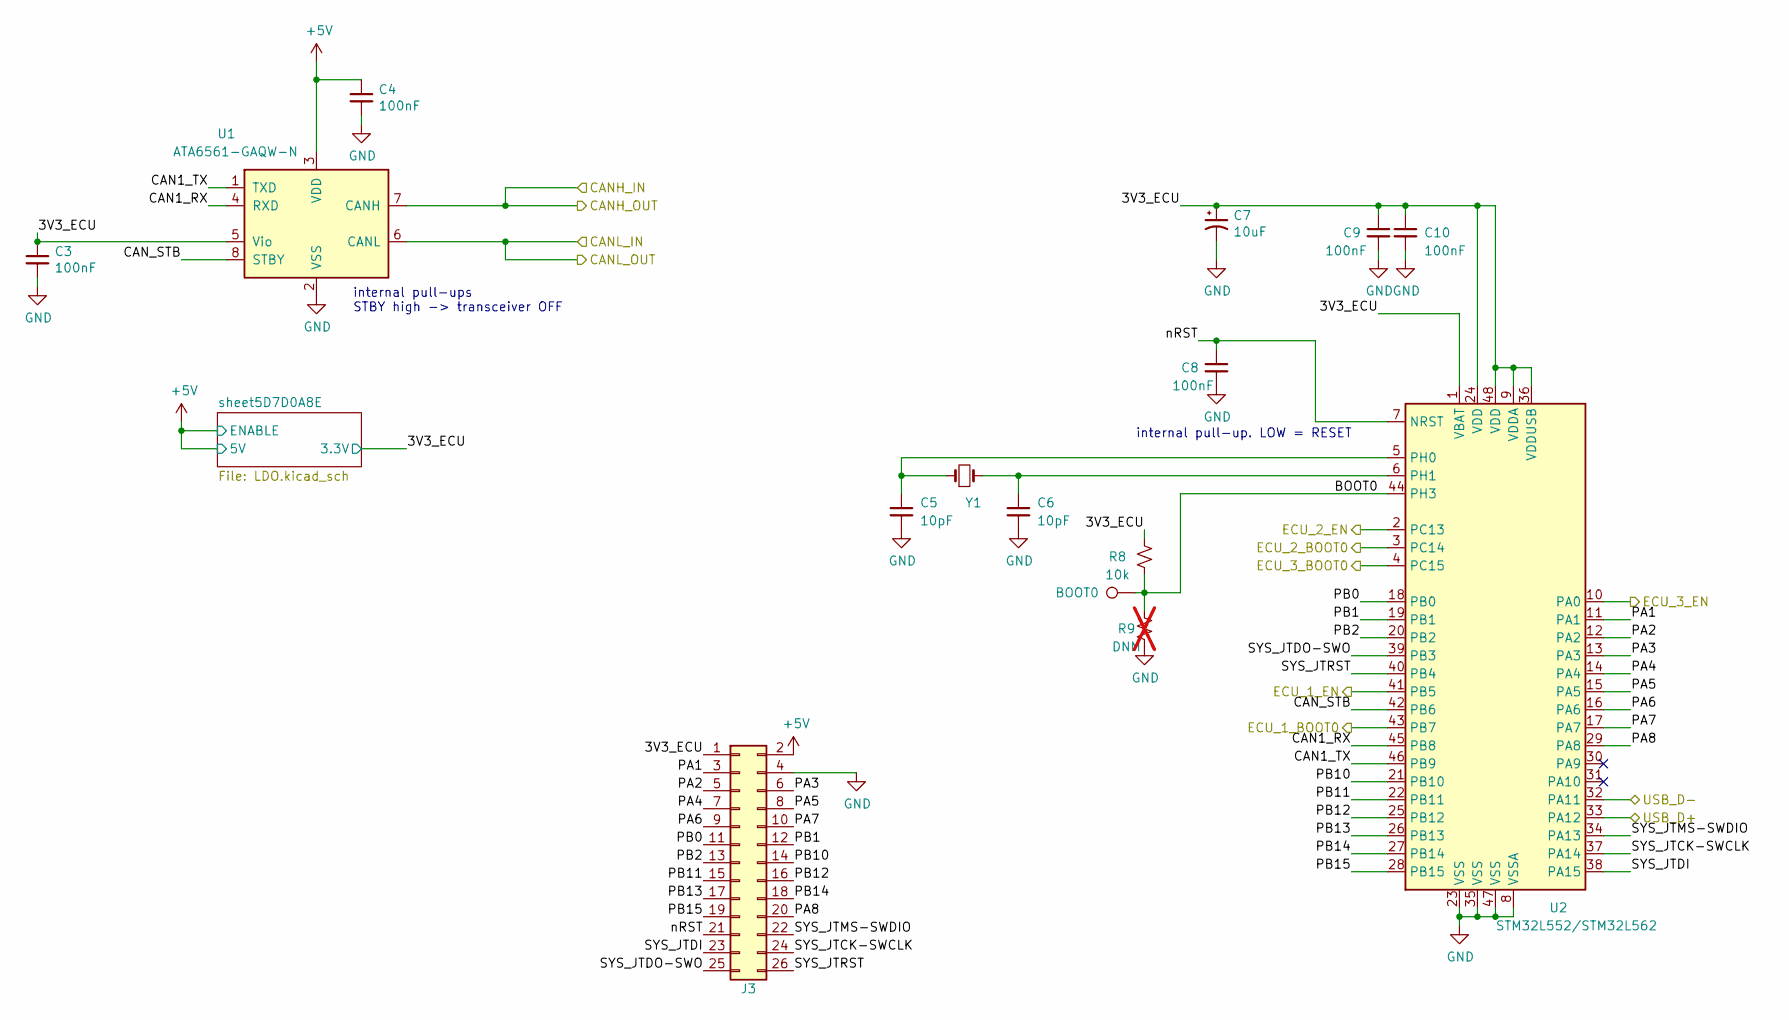
[picture p15: schematic usb_uc.kicad_sch, RAMN: Resistant Automotive Miniature Network V1.0]

Parts:
BOOT0: TestPoint_Pad_D1.0mm; lcsc# C5277086
C3, C4, C8, C9, C10: 100nF; C_0603_1608Metric; lcsc# C599645
C5, C6: 10pF; C_0603_1608Metric; lcsc# C9807
C7: 10uF; C_1206_3216Metric; lcsc# C1848
J3: PinSocket_2x13_P2.54mm_Vertical; lcsc# C2897414
R8: 10k; R_0603_1608Metric; lcsc# C98220
R9: DNM; R_0603_1608Metric; not fitted
U1: ATA6561-GAQW-N; SOIC-8_3.9x4.9mm_P1.27mm; lcsc# C124015
U2: STM32L552/STM32L562; LQFP-48_7x7mm_P0.5mm; lcsc# C2969980
Y1: NX3225GD-8MHZ-STD-CRA-3; SMD-2_3.2x2.5mm; lcsc# C889706

Connections:
+5V: C4.1, J3.2, U1.3 (VDD); also elsewhere on the board
/ECUB/BOOT0: U2.43 (PB7); also elsewhere on the board
/ECUB/CANH_IN: U1.7 (CANH); also elsewhere on the board
/ECUB/CANL_IN: U1.6 (CANL); also elsewhere on the board
/ECUB/ECU_ENABLE: U2.41 (PB5); also elsewhere on the board
/ECUC/BOOT0: U2.3 (PC14); also elsewhere on the board
/ECUC/ECU_ENABLE: U2.2 (PC13); also elsewhere on the board
/ECUD/BOOT0: U2.4 (PC15); also elsewhere on the board
/ECUD/ECU_ENABLE: U2.10 (PA0); also elsewhere on the board
/usb_uc/3V3_ECU: C3.1, C7.1, C9.1, C10.1, J3.1, R8.1, U1.5 (Vio), U2.1 (VBAT), U2.9 (VDDA), U2.24 (VDD), U2.36 (VDDUSB), U2.48 (VDD); also elsewhere on the board
/usb_uc/BOOT0: BOOT0.1 (1_1), R8.2, R9.1, U2.44 (PH3)
/usb_uc/CAN1_RX: U1.4 (RXD), U2.45 (PB8)
/usb_uc/CAN1_TX: U1.1 (TXD), U2.46 (PB9)
/usb_uc/CAN_STB: U1.8 (STBY), U2.42 (PB6)
/usb_uc/PA1: J3.3, U2.11 (PA1)
/usb_uc/PA2: J3.5, U2.12 (PA2)
/usb_uc/PA3: J3.6, U2.13 (PA3)
/usb_uc/PA4: J3.7, U2.14 (PA4)
/usb_uc/PA5: J3.8, U2.15 (PA5)
/usb_uc/PA6: J3.9, U2.16 (PA6)
/usb_uc/PA7: J3.10, U2.17 (PA7)
/usb_uc/PA8: J3.20, U2.29 (PA8)
/usb_uc/PB0: J3.11, U2.18 (PB0)
/usb_uc/PB1: J3.12, U2.19 (PB1)
/usb_uc/PB2: J3.13, U2.20 (PB2)
/usb_uc/PB10: J3.14, U2.21 (PB10)
/usb_uc/PB11: J3.15, U2.22 (PB11)
/usb_uc/PB12: J3.16, U2.25 (PB12)
/usb_uc/PB13: J3.17, U2.26 (PB13)
/usb_uc/PB14: J3.18, U2.27 (PB14)
/usb_uc/PB15: J3.19, U2.28 (PB15)
/usb_uc/SYS_JTCK-SWCLK: J3.24, U2.37 (PA14)
/usb_uc/SYS_JTDI: J3.23, U2.38 (PA15)
/usb_uc/SYS_JTDO-SWO: J3.25, U2.39 (PB3)
/usb_uc/SYS_JTMS-SWDIO: J3.22, U2.34 (PA13)
/usb_uc/SYS_JTRST: J3.26, U2.40 (PB4)
/usb_uc/USB_D+: U2.33 (PA12); also elsewhere on the board
/usb_uc/USB_D-: U2.32 (PA11); also elsewhere on the board
/usb_uc/nRST: C8.1, J3.21, U2.7 (NRST)
GND: C3.2, C4.2, C5.2, C6.2, C7.2, C8.2, C9.2, C10.2, J3.4, R9.2, U1.2 (VSS), U2.8 (VSSA), U2.23 (VSS), U2.35 (VSS), U2.47 (VSS); also elsewhere on the board
unnamed: C5.1, U2.5 (PH0), Y1.1
unnamed: C6.1, U2.6 (PH1), Y1.2

Notes on the sheet:
internal pull-up. LOW = RESET
internal pull-ups STBY high -> transceiver OFF

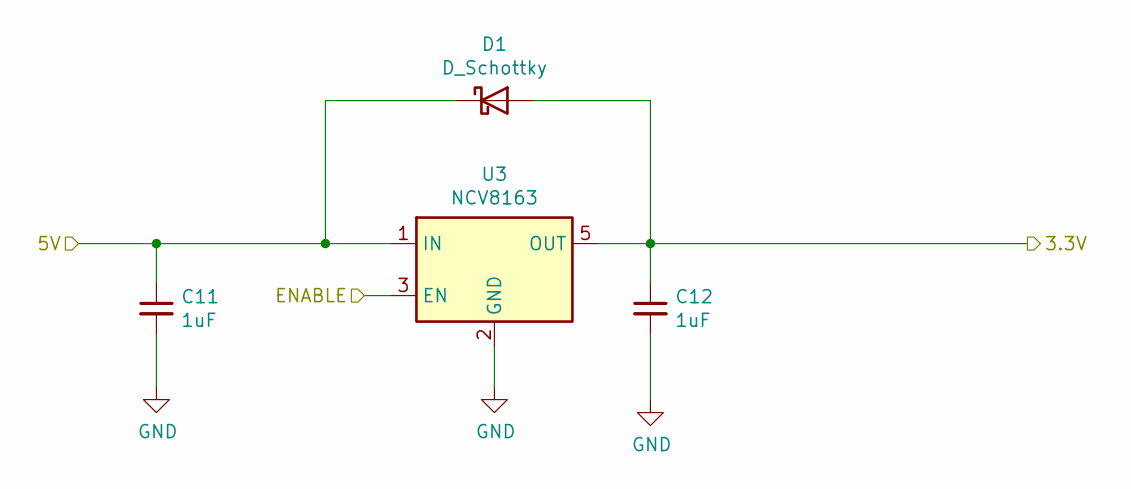
[picture p16: schematic LDO.kicad_sch, RAMN: Resistant Automotive Miniature Network V1.0]

Parts:
C11, C12: 1uF; C_1206_3216Metric; lcsc# C90539
D1: D_Schottky; D_SOD-523; lcsc# C154821
U3: NCV8163; TSOP-5_1.65x3.05mm_P0.95mm; lcsc# C604041

Connections:
+5V: C11.1, D1.1 (K), U3.1 (IN), U3.3 (EN); also elsewhere on the board
/usb_uc/3V3_ECU: C12.1, D1.2 (A), U3.5 (OUT); also elsewhere on the board
GND: C11.2, C12.2, U3.2 (GND); also elsewhere on the board

Parts of its further copies:
C21, C22, C31, C32, C41, C42: 1uF; C_1206_3216Metric; lcsc# C90539
D2, D3, D4: D_Schottky; D_SOD-523; lcsc# C154821
U6, U9, U12: NCV8163; TSOP-5_1.65x3.05mm_P0.95mm; lcsc# C604041

Connections of its further copies:
+5V: C21.1, C31.1, C41.1, D2.1 (K), D3.1 (K), D4.1 (K), U6.1 (IN), U9.1 (IN), U12.1 (IN); also elsewhere on the board
/ECUB/3V3_ECU: C22.1, D2.2 (A), U6.5 (OUT); also elsewhere on the board
/ECUB/ECU_ENABLE: U6.3 (EN); also elsewhere on the board
/ECUC/3V3_ECU: C32.1, D3.2 (A), U9.5 (OUT); also elsewhere on the board
/ECUC/ECU_ENABLE: U9.3 (EN); also elsewhere on the board
/ECUD/ECU_ENABLE: U12.3 (EN); also elsewhere on the board
/ECUD/sheet5D7F273B/3.3V: C42.1, D4.2 (A), U12.5 (OUT); also elsewhere on the board
GND: C21.2, C22.2, C31.2, C32.2, C41.2, C42.2, U6.2 (GND), U9.2 (GND), U12.2 (GND); also elsewhere on the board

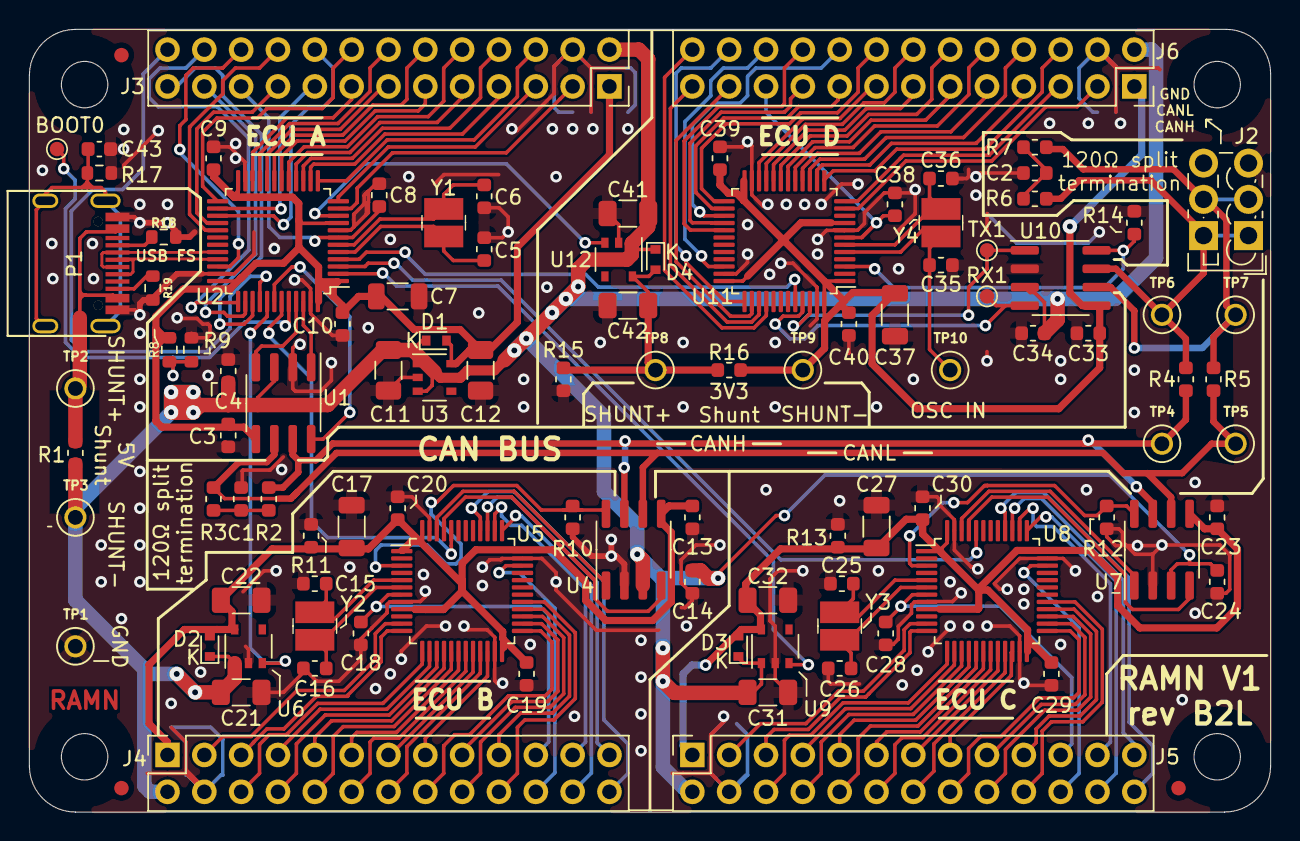
[picture p17: board ramn.kicad_pcb from above]

Board: 2 copper layers, 85.6 x 54.0 mm, 108 parts (0 on the bottom side), 138 nets.
