ElectronicCats/RAMN/(commit log)

2024-08-29 feat (hw): change USB to USB C and change Test points footprints
    [5002.step, LDO.kicad_sch, powertrain.kicad_pcb, powertrain.kicad_sch, ramn.kicad_pcb, ramn.kicad_sch, sc_uc.kicad_sch, usb_uc.kicad_sch]
2024-08-29 fix (hw): update Test point footprint
    [ramn.kicad_pcb]
2024-08-29 feat: test points in body got changed
    [body.kicad_pcb, body.kicad_sch]
2024-08-29 feat: debugger test points changed
    [debugger.kicad_pcb, debugger.kicad_sch]
2024-08-30 feat: potentiometer footprint changed
    [chassis.kicad_pcb, chassis.kicad_sch]
2024-09-01 fix: update files
    [ramn.kicad_pcb]
2026-08-18 Feat(Hw): Modify_and_fix_footprints_and_symbols
    [LDO.kicad_sch, body.kicad_pcb, body.kicad_sch, chassis.kicad_pcb, chassis.kicad_sch, powertrain.kicad_pcb, powertrain.kicad_sch, ramn.kicad_pcb]
2026-08-20 Feat(Hw): EnhanceComponentLibraries
    [body.kicad_pcb, body.kicad_sch, chassis.kicad_pcb, chassis.kicad_sch, debugger.kicad_pcb, powertrain.kicad_pcb, powertrain.kicad_sch]
2026-08-20 Feat(Hw): UpdateKiCadProjectAndStandardizeComponentProperties
    [LDO.kicad_sch, body.kicad_pcb, body.kicad_sch, chassis.kicad_pcb, chassis.kicad_sch, debugger.kicad_pcb, debugger.kicad_sch, powertrain.kicad_pcb]
