ElectronicCats/RAMN/(notices)

Notices in the files:
hardware/V1_revB/0_ramn/sc_uc.kicad_sch:
Copyright (c) 2024 TOYOTA MOTOR CORPORATION. ALL RIGHTS RESERVED.
License: CC BY-SA 4.0
hardware/V1_revB/1_screens/screens.kicad_sch:
Copyright (c) 2021 TOYOTA MOTOR CORPORATION. ALL RIGHTS RESERVED.
